cantimpl0ra/LeafLabProject/The LeafLab Project.pdf

## Seguretat en Sistemes, Xarxes i Serveis

# The LeafLab Project

## Desenvolupament d’un hivernacle intel·ligent

# The LeafLab Project

# The LeafLab Project

### Desenvolupament d’un hivernacle intel·ligent

# INTRODUCCIÓ

## Objectiu del projecte

Aquest projecte consisteix en el desenvolupament d’un hivernacle intel·ligent que ens permeti cuidar la planta d’una manera automàtica i, sobretot, efectiva.

El cervell del nostre hivernacle serà un microcontrolador, concretament, el Arduino MKR WiFi 1010. Aquest serà l’encarregat de captar les condicions ambientals mitjançant sensors. Les variables ambientals seran regulades mitjançant actuadors per tal d’aconseguir un clima òptim per la planta.

A més, el sistema integra un servidor web i una “dashboard”, que permeten visualitzar les dades en temps real i consultar l’històric d’evolució de les condicions de l’hivernacle.

En conclusió, el projecte pretén oferir una solució modular, escalable i de baix cost per al control ambiental d’hivernacles petits o domèstics .

## Funcionalitats

- Monitorar en temps real variables ambientals:
- Humitat del sòl.
- Humitat de l’aire.
- Temperatura de l’aire.
- Automatitzar el control de temperatura i humitat ambientals:
- Activar el refrigerador per excés de temperatura.
- Activar el calefactor per baixa temperatura.
- Activar el humidificador per humitat de l’aire baixa.

- Activar el deshumidificador per excés d’humitat.
- Activar la bomba d’aigua per humitat de sòl baixa.
- Activar i desactivar manualment amb els botons d’Arduino:
- Bomba d’aigua.
- Calefactor.
- Humidificador.
- Deshumidificador + Refrigerador.
- Servidor MQTT:
- Responsable de la comunicació amb Arduino.
- Responsable de la comunicació amb Node-Red.
- Dashboard:
- Mostra de les dades en temps real mitjançant gràfics.
- Mostra de l’estat dels actuadors en temps real.
- Permetre a l’usuari canviar de fase.
- Històric de dades:
- Enregistrament periòdic (cada 2 minuts) a la targeta SD.

# PRESSUPOST

## Plaques Arduino

Arduino MKR 1010 WiFi (https://www.amazon.es/ARDUINO-MKR-WIFI-1010-ABX00023/dp/B07FYFF5YZ?mcid=19bfd3a5e60234389607433262578ab7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) | 30€
Arduino IoT Carrier (https://store.arduino.cc/products/mkr-iot-carrier-rev2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) | 80€

## Fonts alimentació

Transformador 220v a 12v 300W 25A (https://www.amazon.es/-/en/dp/B0C8CHZKJ1) | 20€

## Cablejat

Cables sensors 25m 22AWG 0,3mm (https://es.aliexpress.com/item/1005007470952627.html) | 6€
Cables actuadors 10m 14AWG 2,5mm (https://es.aliexpress.com/item/1005006647928006.html) | 13€
Connectors Wago 5 a 1 (https://es.aliexpress.com/item/1005007008409625.html) | 5€
Connectors Wago 1 a 1 (https://es.aliexpress.com/item/1005007008409625.html) | 4€

## Eines

Pelacables (https://www.amazon.es/Preciva-Pelacables-Profesional-Herramienta-Multifunci%C3%B3n/dp/B0CMQ1ZRQ8) | 12€
Crimpadora Dupont (https://www.amazon.es/-/en/dp/B0DXDZ5LPP) | 30€

## Moduls Relé

IoT Power Relay 220-240V (https://www.digikey.es/es/products/detail/adafruit-industries-llc/2935/6227071) | 40€
8 Channel I2C Electromagnetic Relay Module Opto Isolated PCF8574 3.3V 5.0 (https://www.tindie.com/products/bugrovs2012/8-channel-i2c-electromagnetic-relay-module-opto/) | 15€

## Sensors

Sensor d’humitat del sòl (I2C) (https://www.digikey.es/es/products/detail/adafruit-industries-llc/4026/9745252) | 8€

## Actuadors baix voltatge

Ventilador calefactor d’aire 12V (https://es.aliexpress.com/item/1005008793151500.html) | 16€
Mòdul humidificador 5V (https://es.aliexpress.com/item/1005007893354989.html?curPageLogUid=R73KgMLyuEsj) | 6€
Bomba d’aigua submergible 12V (https://es.aliexpress.com/item/1005008568962671.html?curPageLogUid=hL3NAoTn8mza) | 10€

## Actuadors 240V

Deshumidificador petit (https://www.leroymerlin.es/productos/deshumidificador-eficiente-para-el-hogar-portatil-y-de-bajo-consumo-blanco-tamano-de-habitacion-15-m2-caudal-de-aire-1-5-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) | 30€
“Pinguino” refrigerador (https://cecotec.es/aires-acondicionados-portatiles/forceclima-7400-soundless-touch-08171-04) | 200€

# INFORMACIÓ TÈCNICA

## Especificacions de les plaques

Arduino MKR WiFi 1010 (https://docs.arduino.cc/resources/datasheets/ABX00023-datasheet.pdf) Alimentació: 5V per USB, 3.7V-5.5V per VIN Lògica: 3.3V 61.5 mm × 25 mm 32g

Arduino MKR IoT Carrier (https://docs.arduino.cc/resources/datasheets/ABX00073-datasheet.pdf) Alimentació: subministrada totalment per la placa 1010 a 5V. Lògica: 3.3V 86 mm × 86 mm 65g

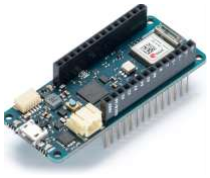
[picture p1: figure]
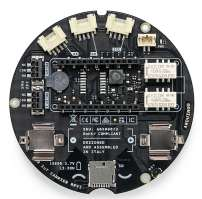
[picture p2: figure]

## Especificacions de les fonts d’alimentació

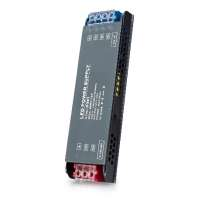
[picture p3: figure]

Font alimentació AC-DC (https://www.amazon.es/-/en/dp/B0C8CHZKJ1)

Tensió d’entrada: 180 – 240V AC 50/60Hz

Tensió de sortida: 12V DC

Potencia nominal: 300W

Corrent màxima de sortida: 20A

## Especificacions dels mòduls relés

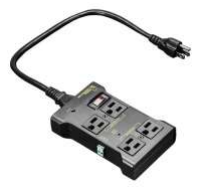
[picture p4: figure]

Mòdul relé iot (https://www.digikey.es/es/products/detail/adafruit-industries-llc/2935/6227071) Tensió d’alimentació 240V AC Interfície de control: digital

Mòdul relé i2c (https://www.tindie.com/products/bugrovs2012/8-channel-i2c-electromagnetic-relay-module-opto/) Tensió d’alimentació 5V DC Interfície de control i2c Aïllament optoacoplat. És a dir, la lògia és alimentada per l’arduino i els actuadors son alimentats amb una font d’alimentació externa.

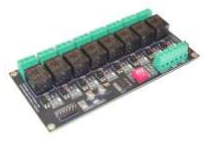
[picture p5: figure]

## Especificacions del cablejat

Cables pels sensors i circuiteria

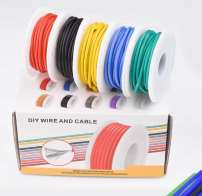
[picture p6: figure]

Material revestiment: Silicona

Material conductor: coure estanyat multifilament

Grossor del cable: 14AWG

Rang de temperatura ambient: -60C a +200C

Màxim 3A

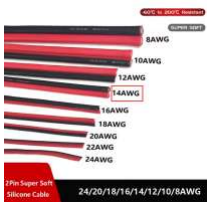
[picture p7: figure]

Cable pels actuadors Material revestiment: Silicona Material conductor: coure estanyat multifilament Grossor del cable: 14AWG Rang de temperatura ambient: -60C a +200C Màxim 20A

Material: PC 250V màxim 32A màxim Grossor del cable: 0.08 – 2.5 mm2 (28-14 AWG) Llargada del pelat del cable: 9mm

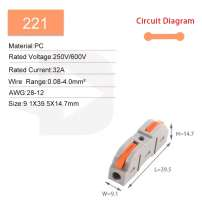
[picture p8: figure]

Material: PC 250V màxim 32A màxim Grossor del cable: 0.08 – 2.5 mm2 (28-14 AWG) Llargada del pelat del cable: 9mm

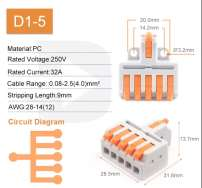
[picture p9: figure]

## Especificacions dels sensors

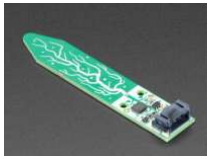
[picture p10: figure]

Adafruit STEMMA Soil Sensor (https://cdn-learn.adafruit.com/downloads/pdf/adafruit-stemma-soil-sensor-i2c-capacitive-moisture-sensor.pdf) Mesura la humitat del sòl ~200 (molt sec) – ~2000 (molt humit) 5V DC 54 × 20 12g Sortida I2C (0x36)

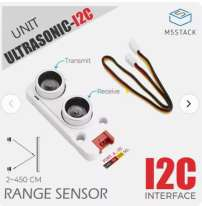
[picture p11: figure]

RCWL-9620 (https://m5stack.oss-cn-shenzhen.aliyuncs.com/resource/docs/static/pdf/static/en/unit/ULTRASONIC%20I2C.pdf) Sensor ultrasònic impermeable de nivell d’aigua. Distància. 2 cm – 450 cm ±1 cm 3.3V - 5V DC 54 × 24 × 18 mm 12g Sortida I2C.

## Especificacions dels actuadors

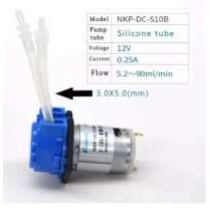
[picture p12: figure]

NKP-DC-S10B (https://robu.in/wp-content/uploads/2021/08/NKP-Peristaltic-Pump-Data-Sheet.pdf)

Bomba de líquids peristàltica amb tub de silicona

5.2 – 90 mL/min

Diàmetre tub: 3.0 × 5.0 mm (interior ×

exterior)

5W 12V DC

Consum aproximat de 1A

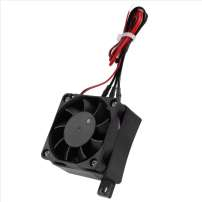
[picture p13: figure]

Calefactor (https://es.aliexpress.com/item/1005008793151500.html) Generació d’aire calent mitjançant resistència elèctrica i ventilador integrat. 100W 12V Consum aproximat de 8A

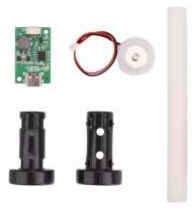
[picture p14: figure]

Humidificador (https://es.aliexpress.com/item/1005008785449657.html) Nebulitzador ultrasònic tipo C. 5W 5V Consum aproximat de 1A

# ESQUEMA CONNEXIONS

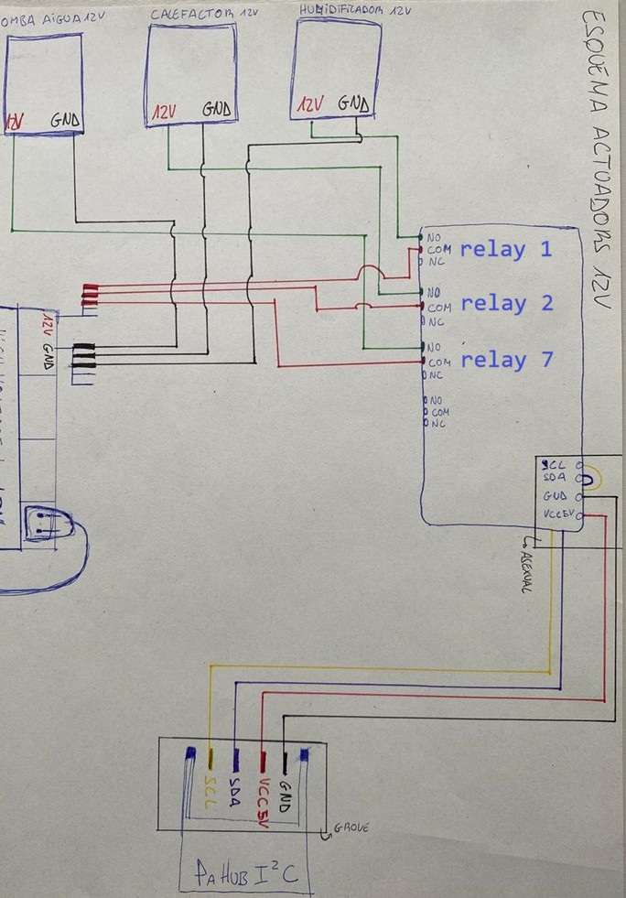
[picture p15: figure]
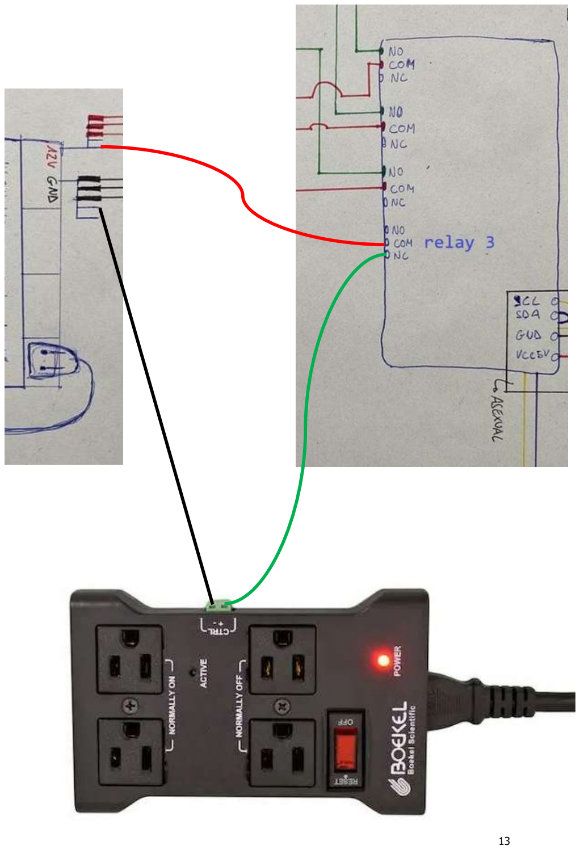
[picture p16: page 14]

# CODI ARDUINO

## Tests inicials de hardware

Aquest codi consisteix en comprovar que tot el hardware està ben connectat i funciona correctament.

https://github.com/cantimpl0ra/LeafLabProject/tree/main/LeafLabProject/codiTestHardware (https://github.com/cantimpl0ra/LeafLabProject/tree/main/LeafLabProject/codiTestHardware)

## Codi complert d’automatització

https://github.com/cantimpl0ra/LeafLabProject/tree/main/LeafLabProject/codiPrincipal-versioDEF (https://github.com/cantimpl0ra/LeafLabProject/tree/main/LeafLabProject/codiPrincipal-versioDEF)

# CONFIGURACIÓ BROKER MQTT

Aquí podem trobar un vídeo tutorial de com configurar el servidor (broker) MQTT. Per realitzar aquesta configuració necessitarem tenir el servei mosquitto corrent al nostre equip i instal·lar mqtt explorer.

Configuració del servei MQTT:
www.youtube.com/watch?v=sxspkg8U_Lc

Configuració de MQTT Explorer: www.youtube.com/watch?v=atVf_O1mJAs

# CONFIGURACIÓ DASHBOARD NODE-RED

Aquí podem trobar un vídeo tutorial de com muntar la dashboard. En el nostre cas utilitzarem les tecnologies de mqtt i node-red. No és el més potent però és gratuït i ideal per un projecte educatiu.

Instal·lació node-red: nodered.org/docs/getting-started/windows
Configuració node-red: www.youtube.com/watch?v=TNHAZxwB-9o

JSON amb la configuració de node-red llest per importar: https://github.com/cantimpl0ra/LeafLabProject/blob/main/LeafLabProject/node-red_flows.json (https://github.com/cantimpl0ra/LeafLabProject/blob/main/LeafLabProject/node-red_flows.json)

# AMPLIACIÓ

Com a proposta d’ampliació del projecte deixo les dos idees següents:

1. Afegir el mòdul ADS1115 juntament amb els sensors analògics (pH de l’aigua, TDS de l’aigua i qualitat de l’aire).
2. Millorar la dashboard i afegir la funcionalitat per canviar l’estat dels actuadors mitjançant el protocol mqtt.
3. Afegir un sensor de petjada dactilar que activi els botons de la iot carrier i així tenir una capa de seguretat.
